hopeopolot/lab_wsn/figures/Humidity_vs_Time.png

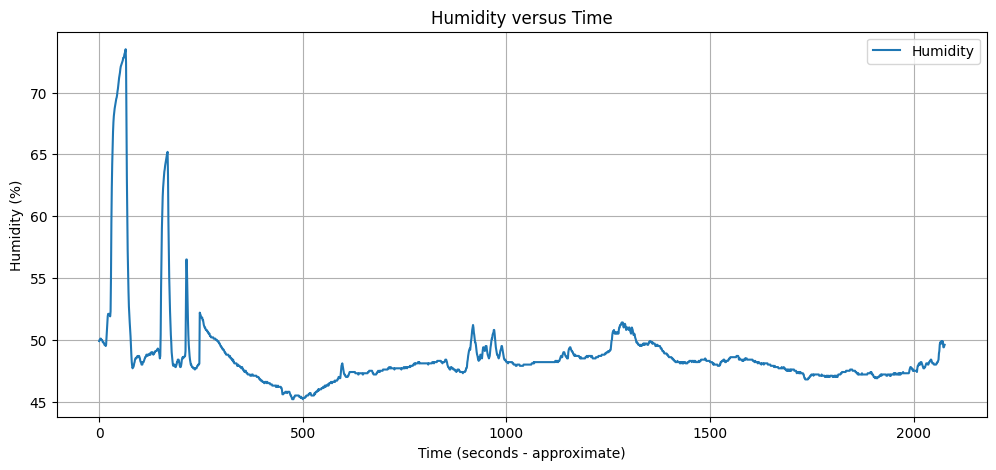
figures/Humidity_vs_Time.png
