hopeopolot/lab_wsn/figures/Light_Sensor_vs_Time.png

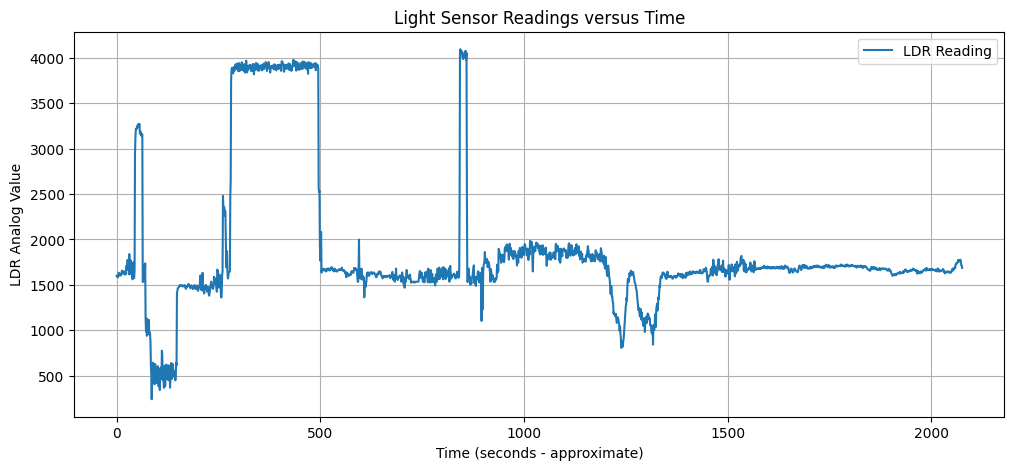
figures/Light_Sensor_vs_Time.png
