hopeopolot/lab_wsn/figures/Temperature_vs_Time.png

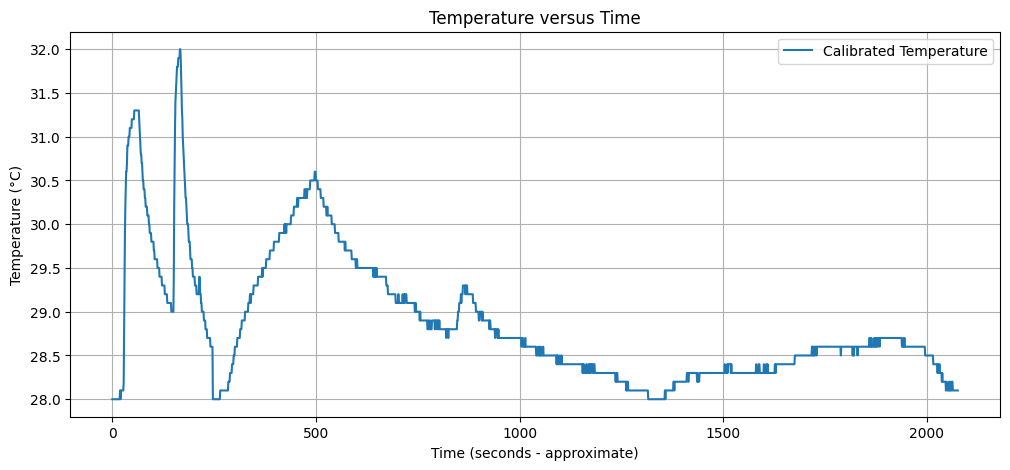
figures/Temperature_vs_Time.png
