hopeopolot/lab_wsn/figures/Raw_vs_Calibrated_Temperature.png

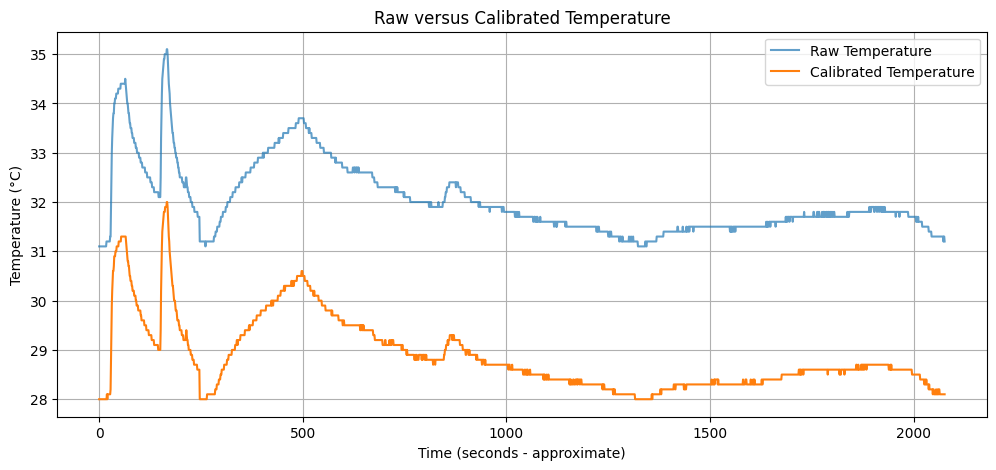
figures/Raw_vs_Calibrated_Temperature.png
